hotchk155/d-ticker/docs/d-ticker.docx

Four pots – each defines the acceleration for 25% of the bar length

Click button for manual reset

Hold button and turn | Function and LED indication
POTA | Bar length - 4 input steps - 8 input steps - 16 input steps (default) - 32 input steps
POTB | Output rate multiplier - Divide by 2 - 1:1 (default) - Multiply by 2 - Multiply by 4
POTC | Reset mode - Restart and run freely (default) - Restart and run once - Restart and run only while high - Run while high, do not reset
POTD | Internal clock tempo (when no external clock) – 30 .. 220bpm
