hotchk155/d-ticker/hardware/d-ticker.brd

## EAGLE design hardware/d-ticker.brd (2025-03-30)

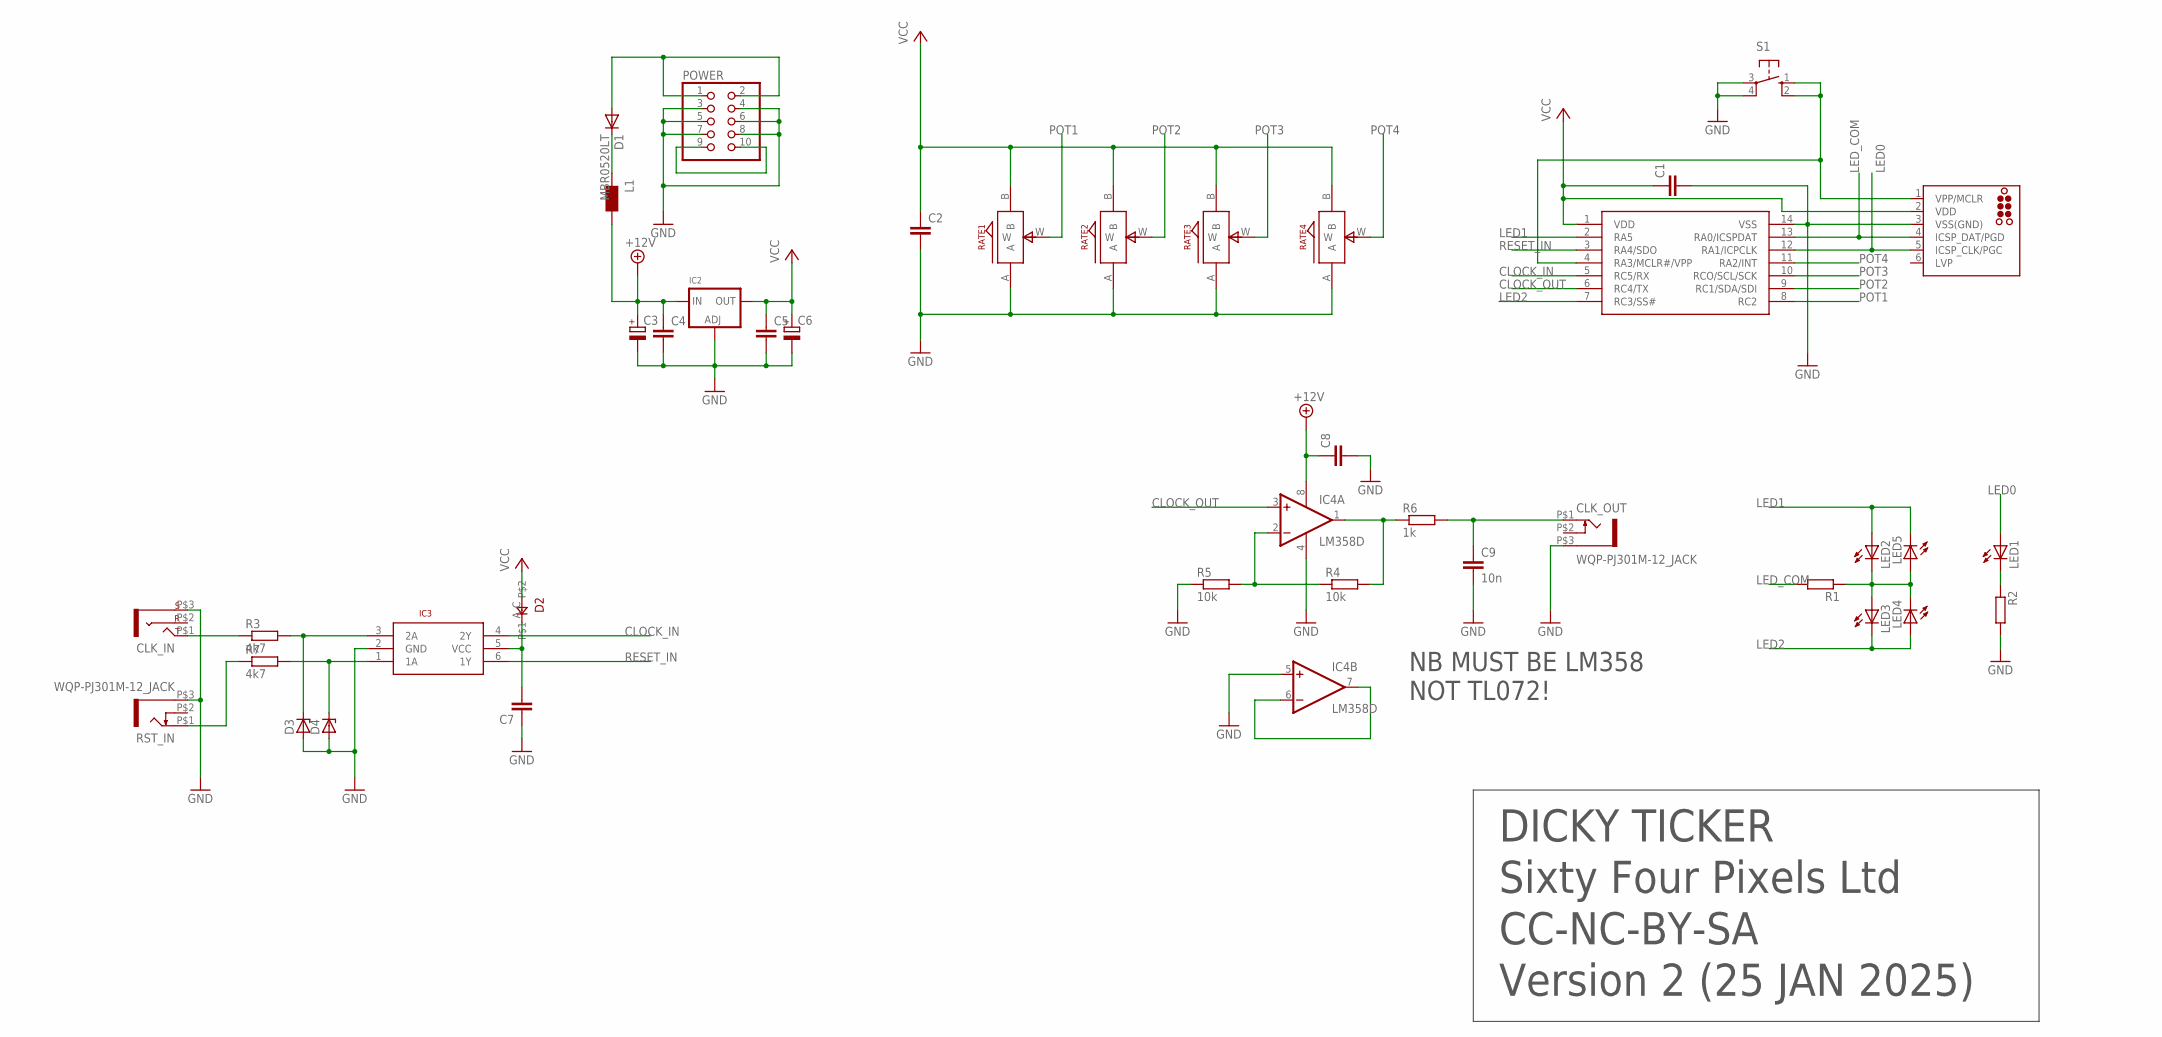
[picture p1: schematic d-ticker.sch]

Parts:
C1, C2, C4, C5, C7, C8: C-EUC0805; C0805
C3, C6: CPOL-EUSMCA; SMC_A
C9: 10n; C0805
CLK_IN: THONKICONN_STEREO; WQP-PJ301M-ST
CLK_OUT: WQP-PJ301M-12_JACK
D1: MBR0520LT; SOD123
D2: 0805DIODE
D3, D4: ZENER-DIODESOD80C; SOD80C
IC1: PIC16F1825SO14; SO14
IC2: LM1117SOT223-WAVE; SOT223-W
IC3: SN74LVC2G14; DBV_R-PDSO-G6
IC4: LM358D; SO08
ICSP: TC2030-MCP-NL
L1: WE-CBF_0805; 0805
LED1, LED2, LED3, LED4, LED5: LED3MM
POWER: PINHD-2X5; 2X05
R1, R2: R-EU_R0805; R0805
R3, R7: 4k7; R0805
R4, R5: 10k; R0805
R6: 1k; R0805
RATE1, RATE2, RATE3, RATE4: ALPS_POT_SMALL; SMALL_ALPS_POT
RST_IN: WQP-PJ301M-12_JACK
S1: 10-XX; B3F-10XX

Connections:
+12V: C3.+, C4.1, C8.1, IC2.3 (IN), IC4.8 (V+), L1.2
CLOCK_IN: IC1.5 (RC5/RX), IC3.4 (2Y)
CLOCK_OUT: IC1.6 (RC4/TX), IC4.3 (+IN)
GND: C1.2, C2.2, C3.-, C4.2, C5.2, C6.-, C7.1, C8.2, C9.2, CLK_IN.P$3 (S), CLK_OUT.P$3 (1), D3.A, D4.A, IC1.14 (VSS), IC2.1 (ADJ), IC3.2 (GND), IC4.4 (V-), IC4.5 (+IN), ICSP.3 (VSS(GND)), POWER.3, POWER.4, POWER.5, POWER.6, POWER.7, POWER.8, R2.2, R5.1, RATE1.A, RATE2.A, RATE3.A, RATE4.A, RST_IN.P$3 (1), S1.3, S1.4 (P1)
LED0: IC1.12 (RA1/ICPCLK), ICSP.5 (ICSP_CLK/PGC), LED1.A
LED1: IC1.2 (RA5), LED2.A, LED5.K (C)
LED2: IC1.7 (RC3/SS#), LED3.K (C), LED4.A
LED_COM: IC1.13 (RA0/ICSPDAT), ICSP.4 (ICSP_DAT/PGD), R1.2
unnamed: CLK_IN.P$1 (T), R3.1
unnamed: C7.2, D2.A, IC3.5 (VCC)
unnamed: IC4.2 (-IN), R4.1, R5.2
unnamed: R7.1, RST_IN.P$1 (2)
unnamed: IC4.6 (-IN), IC4.7 (OUT)
unnamed: LED1.K (C), R2.1
unnamed: IC4.1 (OUT), R4.2, R6.1
unnamed: C9.1, CLK_OUT.P$1 (2), R6.2
unnamed: POWER.9, POWER.10
unnamed: D1.A, POWER.1, POWER.2
unnamed: LED2.K (C), LED3.A, LED4.K (C), LED5.A, R1.1
unnamed: D1.C, L1.1
unnamed: D3.C, IC3.3 (2A), R3.2
unnamed: D4.C, IC3.1 (1A), R7.2
unnamed: IC1.4 (RA3/MCLR#/VPP), ICSP.1 (VPP/MCLR), S1.1 (S), S1.2 (S1)
POT1: IC1.8 (RC2), RATE1.W
POT2: IC1.9 (RC1/SDA/SDI), RATE2.W
POT3: IC1.10 (RCO/SCL/SCK), RATE3.W
POT4: IC1.11 (RA2/INT), RATE4.W
RESET_IN: IC1.3 (RA4/SDO), IC3.6 (1Y)
VCC: C1.1, C2.1, C5.1, C6.+, D2.C, IC1.1 (VDD), IC2.2 (OUT), ICSP.2 (VDD), RATE1.B, RATE2.B, RATE3.B, RATE4.B

Notes on the sheet:
DICKY TICKER
Sixty Four Pixels Ltd
CC-NC-BY-SA
Version 2 (25 JAN 2025)
NB MUST BE LM358 NOT TL072!

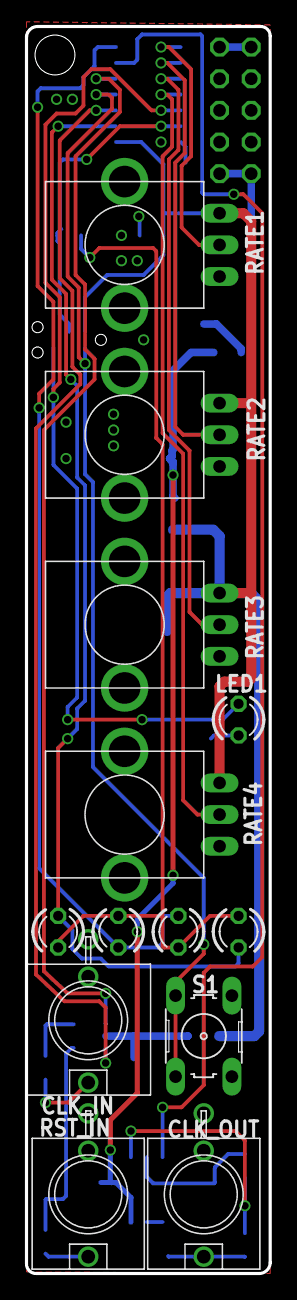
[picture p2: board d-ticker.brd from above]

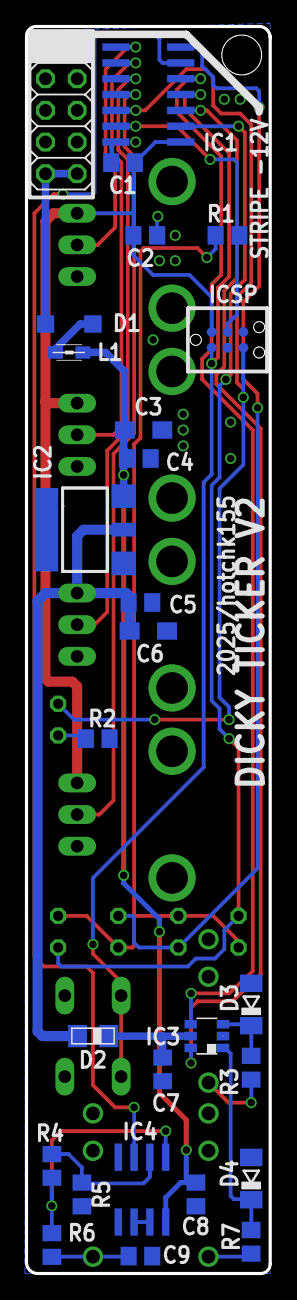
[picture p3: board d-ticker.brd from below]

Board: 2 copper layers, 19.6 x 100.1 mm, 40 parts (27 on the bottom side), 29 nets.
