hotchk155/d-ticker/d-ticker.X/d-ticker.h

#ifndef D_TICKER_H
#define	D_TICKER_H

typedef unsigned char byte;



enum byte {
    RESET_MODE_RESTART,
    RESET_MODE_ONE_SHOT,
    RESET_MODE_RUN,
    RESET_MODE_RESTART_RUN
};
enum {    
    MAX_INPUT_STEPS = 16,
    MAX_OUTPUT_RATE = 4,
    MAX_TRIGS = (MAX_INPUT_STEPS * MAX_OUTPUT_RATE)
};
enum {
    TINY_LED_BLINK_MS = 1,
    SHORT_LED_BLINK_MS = 3,
    MED_LED_BLINK_MS = 30,
    LONG_LED_BLINK_MS = 50
};
////////////////////////////////////////////////////////////////////////////////
inline void clk_ext_pulse_isr(void);
inline void clk_ms_isr(void);
void clk_init(void);
inline void clk_ext_restart_isr();
void clk_manual_restart();
inline byte clk_is_restart(void);
inline unsigned int clk_get_cur_pos(void);
inline int clk_get_cur_step(void);
void clk_set_num_steps(int num_pulses);
void clk_set_bpm(int bpm);



////////////////////////////////////////////////////////////////////////////////
void pat_set_num_trigs(int num_trigs);
inline int pat_get_num_trigs(void);
inline unsigned int pat_get_trig(int pos);
void pat_init(void);
void pat_recalc(void);

////////////////////////////////////////////////////////////////////////////////
void pots_read_isr(void);
void pots_init(void);
inline byte pots_reading(int which);
inline int pots_moved(void);

////////////////////////////////////////////////////////////////////////////////
void leds_init(void);
inline void leds_run(void);
inline void leds_set_clock(byte state, byte timeout);
inline void leds_set_pos(byte which, byte timeout);
inline void leds_clear_pos(void);

///////////////////////////////////////////////////////////////////////////////
void out_init(void);
inline void out_ms_isr(void);
void out_trig(void);

///////////////////////////////////////////////////////////////////////////////
void ui_init(void);
void ui_run(void);
void ui_trig(byte which);

////////////////////////////////////////////////////////////////////////////////
void seq_init(void);
void seq_reset_signal_isr(byte reset_signal);
void seq_run(void);
int seq_get_output_trig(void);
void seq_set_reset_mode(byte reset_mode);


#endif	/* D_TICKER_H */
