hotchk155/d-ticker/d-ticker.X/pattern.c

#include <xc.h>
#include "d-ticker.h"

struct {
    unsigned int trig[MAX_TRIGS];
    int num_trigs;
    int tt[MAX_TRIGS];
} pat;

/////////////////////////////////////////////////////////////////////////////
void pat_set_num_trigs(int num_trigs) {
    pat.num_trigs = num_trigs;
}
/////////////////////////////////////////////////////////////////////////////
inline int pat_get_num_trigs() {
    return pat.num_trigs;
}
/////////////////////////////////////////////////////////////////////////////
inline unsigned int pat_get_trig(int pos) {
    return pat.trig[pos];
}
/////////////////////////////////////////////////////////////////////////////
void pat_init() {
    for(int i=0; i<MAX_TRIGS; ++i) {
        pat.trig[i] = 0;
    }
    pat.num_trigs = 16;
    pat_recalc();
}

/////////////////////////////////////////////////////////////////////////////
// Recalculate the tempo map
/////////////////////////////////////////////////////////////////////////////
void pat_recalc() {
    
    // expand out the velocity(tempo) changes (defined by the pots) into a 
    // list of velocity values at each output trigger position    
    int cur_rate = 128;
    int min_rate = 128;
    for(int i=0; i<pat.num_trigs; ++i) {
        pat.tt[i] = cur_rate;        
        int acc = 128-pots_reading((i*4)/pat.num_trigs);
        cur_rate += acc;
        if(cur_rate < min_rate) {
            min_rate = cur_rate;
        }        
    }
    
    // normalise the velocities so that they are all positive and 
    // expand out the "distance into sequence" by integrating velocity
    int dist = 0;
    for(int i=0; i<pat.num_trigs; ++i) {
        int norm_rate = pat.tt[i] - min_rate + 128;
        pat.tt[i] = dist;
        dist = dist + norm_rate;
    }
    
    // now normalise the distances so that they run from 0 - 65535
    for(int i=0; i<pat.num_trigs; ++i) {
        pat.trig[i] = (unsigned int)(((long)65535 * pat.tt[i]) / dist);
    }
}

/////////////////////////////////////////////////////////////////////////////
// Recalculate the tempo map
/////////////////////////////////////////////////////////////////////////////
void xpat_recalc() {

    
    // now normalise the distances so that they run from 0 - 65535
    for(int i=0; i<pat.num_trigs; ++i) {
        pat.trig[i] = (unsigned int)((65535.0 *i)/pat.num_trigs);
    }
}
