hotchk155/d-ticker/d-ticker.X/tan.h

byte tan_table[128] = {
0, 
2, 
3, 
5, 
6, 
8, 
9, 
11, 
13, 
14, 
16, 
17, 
19, 
21, 
22, 
24, 
25, 
27, 
29, 
30, 
32, 
33, 
35, 
37, 
38, 
40, 
41, 
43, 
45, 
46, 
48, 
49, 
51, 
53, 
54, 
56, 
58, 
59, 
61, 
63, 
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
};
