hotchk155/d-ticker/(commit log)

2025-01-24 turn mcu
    [d-ticker.brd]
2025-01-25 various changes per prototype
    [d-ticker.brd, d-ticker.sch]
2025-03-30 pcb rev 2
    [d-ticker.brd, timetwister.xlsx]
